MaryamGadiali/SmartHomeOfficeHealthSystem/Electronic scripts/Hub/InternalClock.h

#ifndef INTERNALCLOCKH
#define INTERNALCLOCKH
//Definition file

//Class to configure the internal clock(RTC) of the ESP32
class InternalClock{
    public:
    static void configureInternalClock();
};

#endif
