MaryamGadiali/SmartHomeOfficeHealthSystem/Electronic scripts/Hub/WifiSetup.h

#ifndef WifiSetupH
#define WifiSetupH
#include <Arduino.h>
//Definition file

//Class to configure the hub to connect to the home wifi network
class WifiSetup
{
    public:
    static void setUpWifiManager();
};

#endif 
